LceITC/stm32-ecg-spo2-monitor/tmp/pdfs/guide-01.png

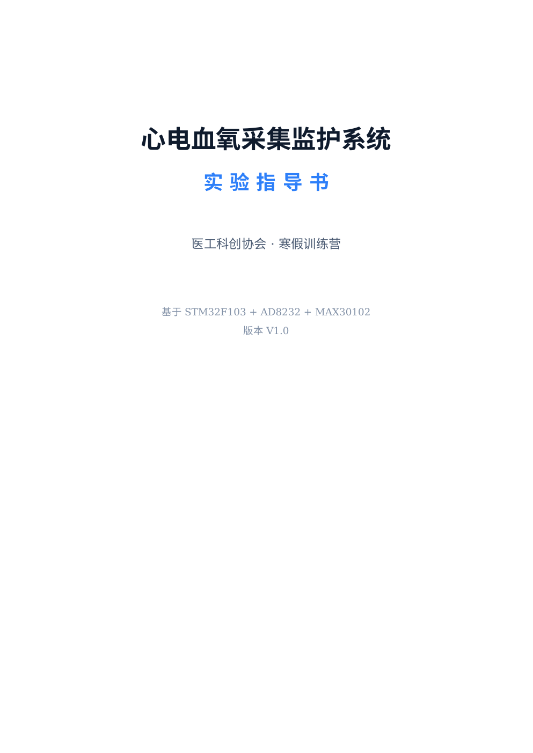
tmp/pdfs/guide-01.png
