LceITC/stm32-ecg-spo2-monitor/tmp/pdfs/guide-07.png

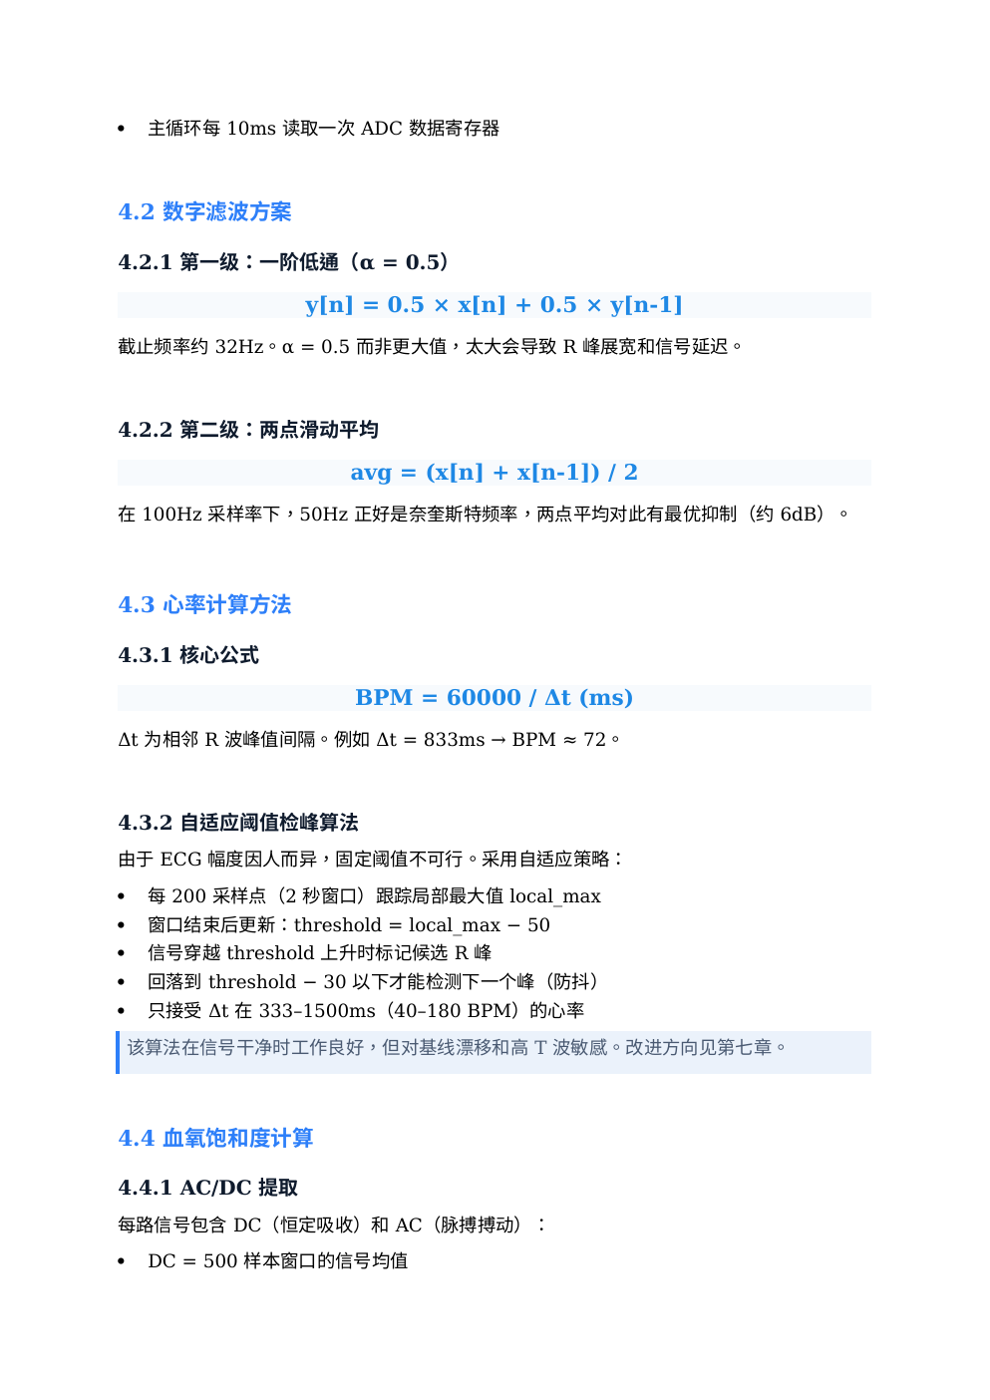
tmp/pdfs/guide-07.png
