LceITC/stm32-ecg-spo2-monitor/tmp/pdfs/guide-09.png

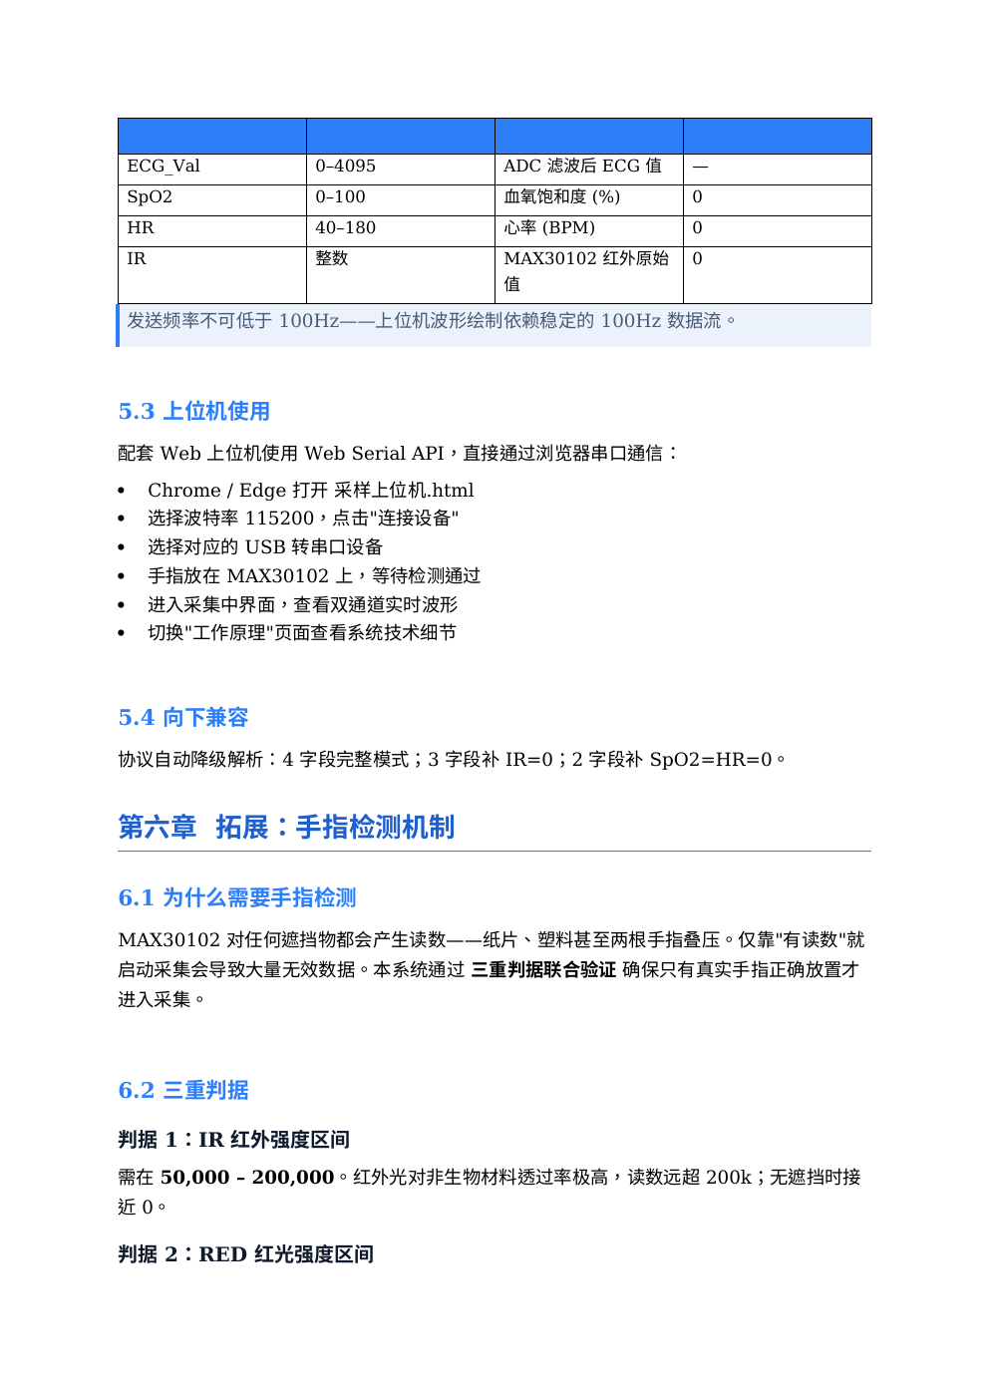
tmp/pdfs/guide-09.png
