LceITC/stm32-ecg-spo2-monitor/tmp/pdfs/guide-10.png

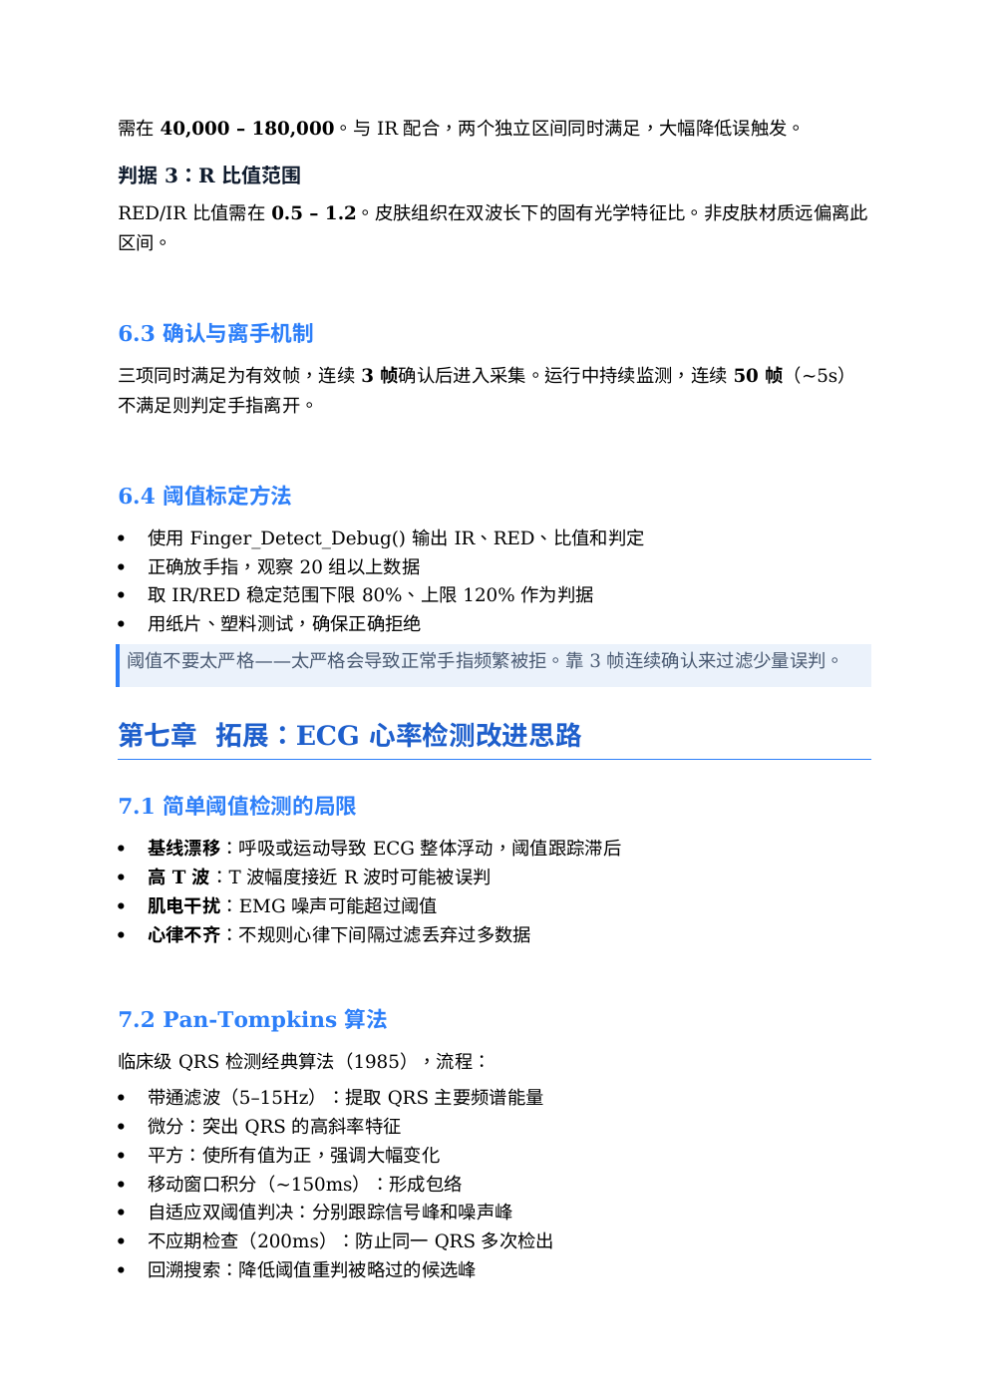
tmp/pdfs/guide-10.png
